MinaNan1/hexapod-ros2/hexapod_path_planning_final/hexapod_path_planning/outputs/inflation_comparison.png

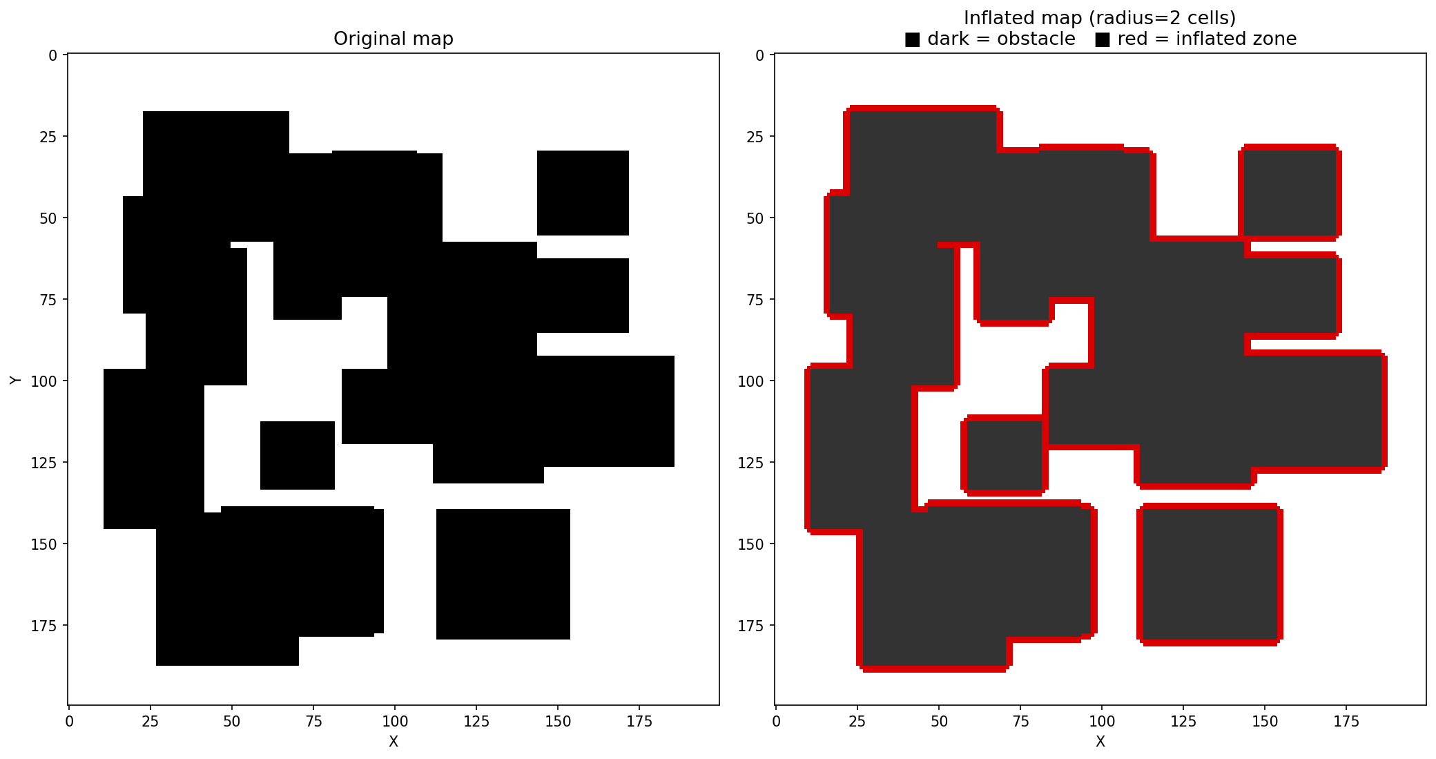
hexapod_path_planning_final/hexapod_path_planning/outputs/inflation_comparison.png
