MinaNan1/hexapod-ros2/hexapod_path_planning_final/hexapod_path_planning/outputs/my_map.png

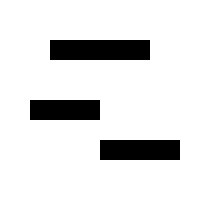
hexapod_path_planning_final/hexapod_path_planning/outputs/my_map.png
