MinaNan1/hexapod-ros2/hexapod_ws/src/hexapod_description/meshes/body_link.STL

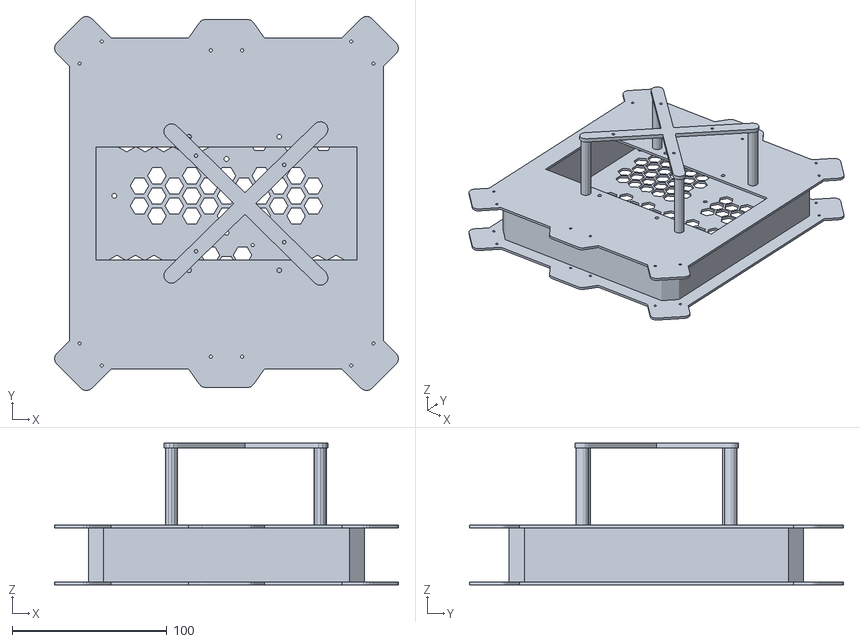
[picture p5: CAD file, 2026-10-06]
hexapod_ws/src/hexapod_description/meshes/body_link.STL
222.6 x 242.2 x 91.6
