MinaNan1/hexapod-ros2/laptop_viz/hexapod_description/meshes/coxa_link.STL

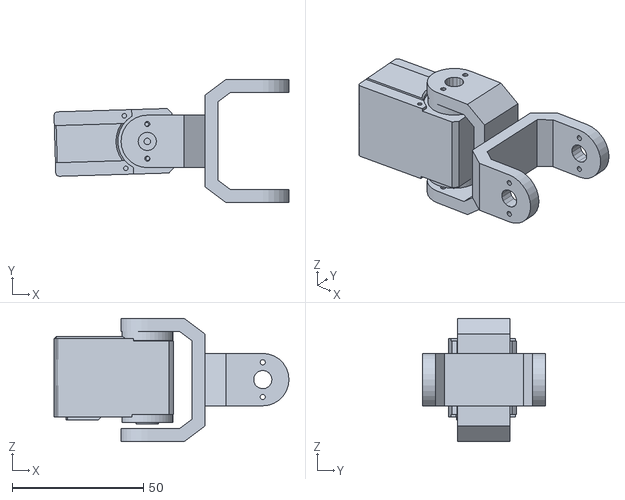
[picture p6: CAD file, 2026-10-06]
laptop_viz/hexapod_description/meshes/coxa_link.STL
89.6 x 47.0 x 47.0
