MinaNan1/hexapod-ros2/hexapod_ws/src/hexapod_description/meshes/femur_link.STL

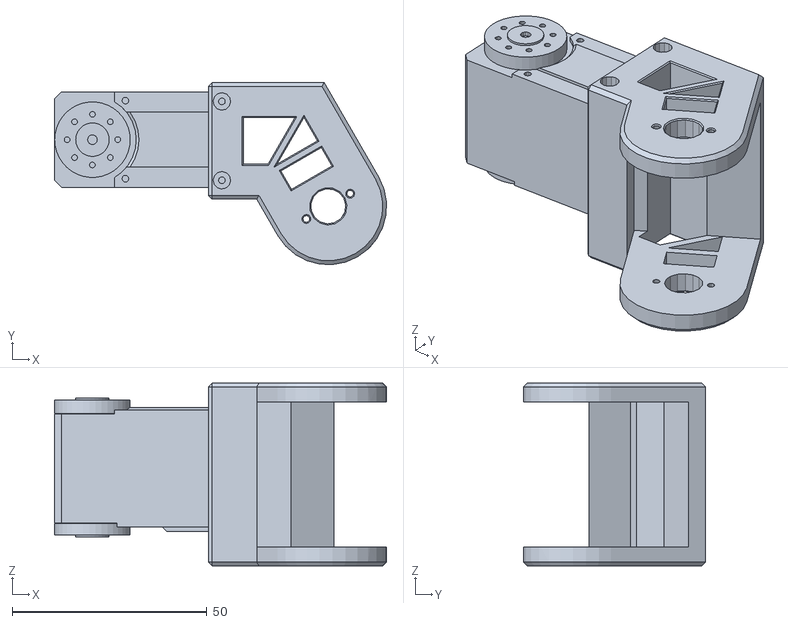
[picture p7: CAD file, 2026-10-06]
hexapod_ws/src/hexapod_description/meshes/femur_link.STL
85.3 x 46.8 x 47.0
