MinaNan1/hexapod-ros2/laptop_viz/hexapod_description/meshes/tibia_link.STL

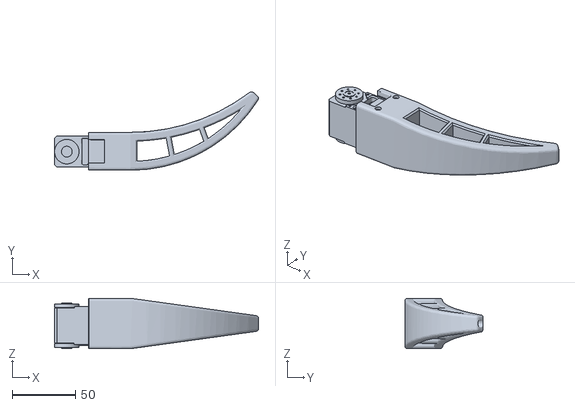
[picture p8: CAD file, 2026-10-06]
laptop_viz/hexapod_description/meshes/tibia_link.STL
161.6 x 62.1 x 40.0
