MinaNan1/hexapod-ros2/hexapod_path_planning_final/hexapod_path_planning/outputs/stage2_exploration_result.png

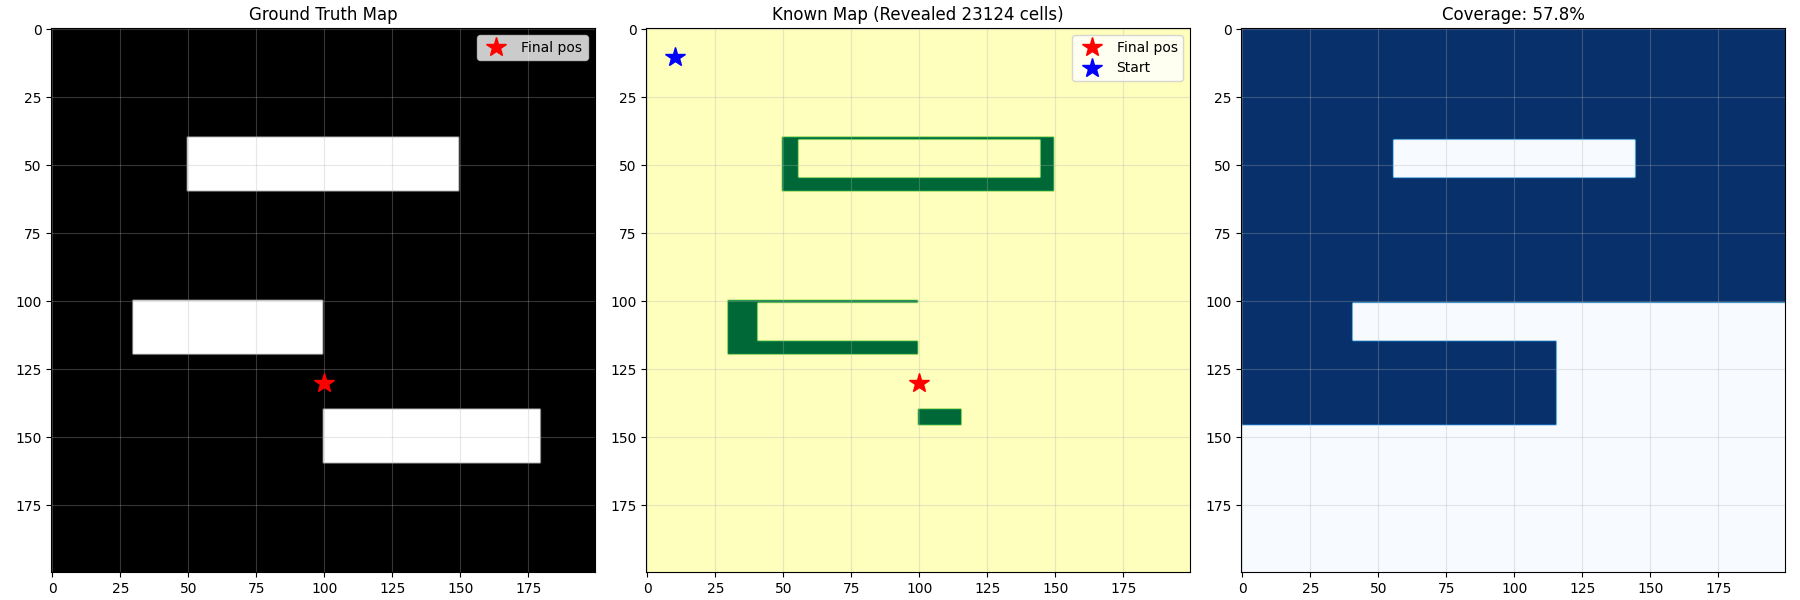
hexapod_path_planning_final/hexapod_path_planning/outputs/stage2_exploration_result.png
